LesKaribous/Karibous-2026-PAMI/README.md

# Project-Template
Template de projet avec documentation
