LesKaribous/Karibous-2026-PAMI/MCAD/squirrel-design/path270-5-2-4-5.png

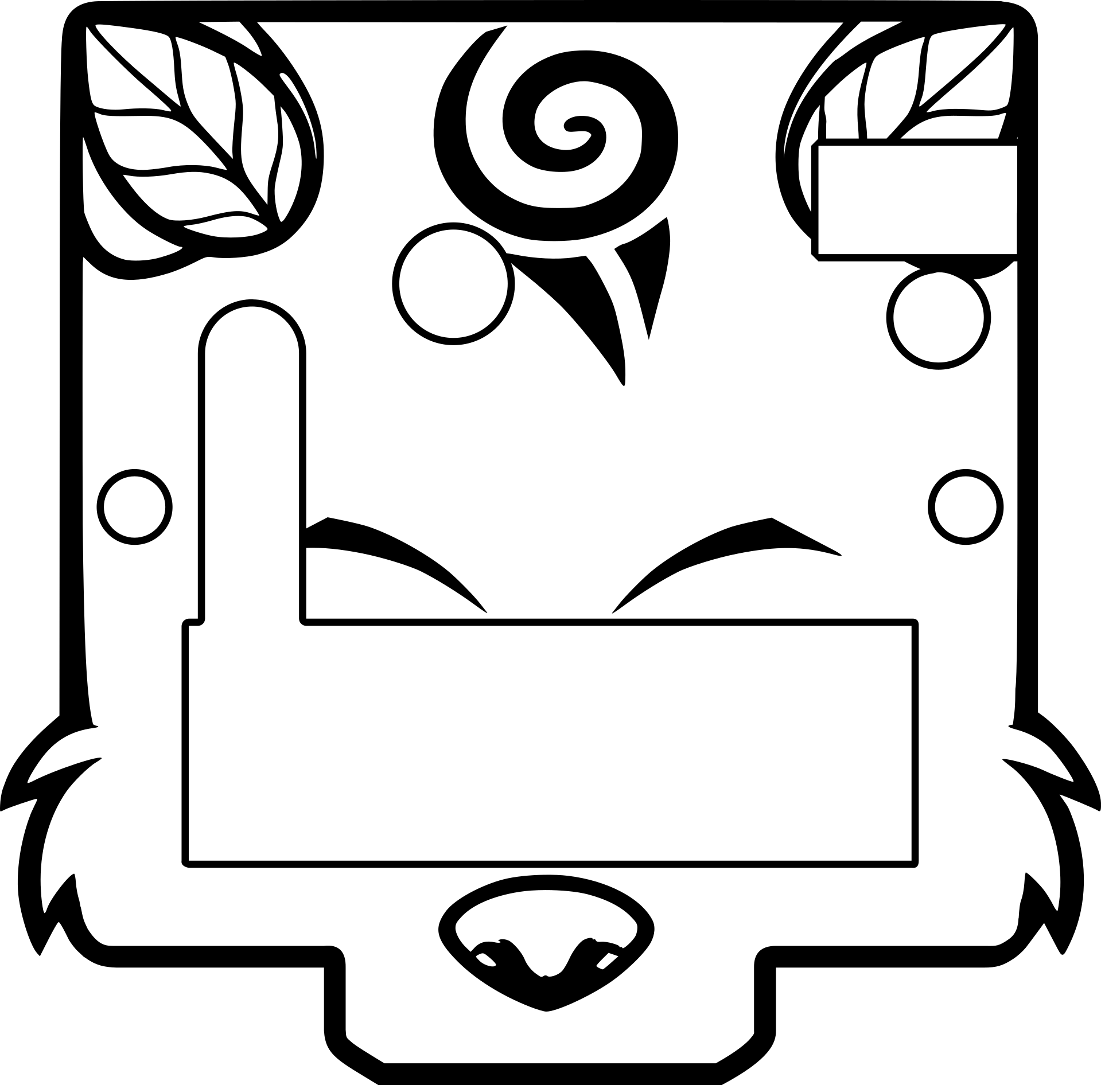
MCAD/squirrel-design/path270-5-2-4-5.png
