LesKaribous/Karibous-2026-PAMI/MCAD/squirrel-design/queueBabyPami.png

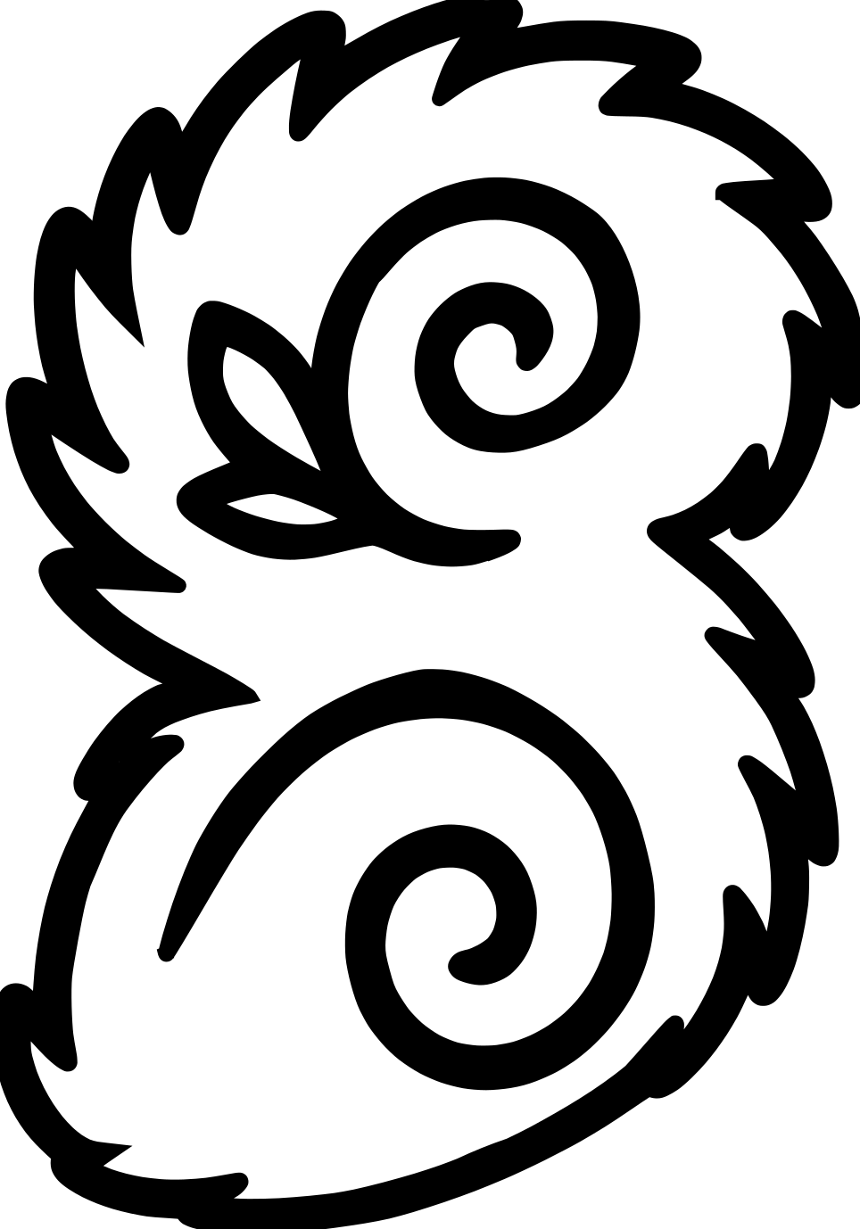
MCAD/squirrel-design/queueBabyPami.png
