LesKaribous/Karibous-2026-PAMI/MCAD/squirrel-design/top.png

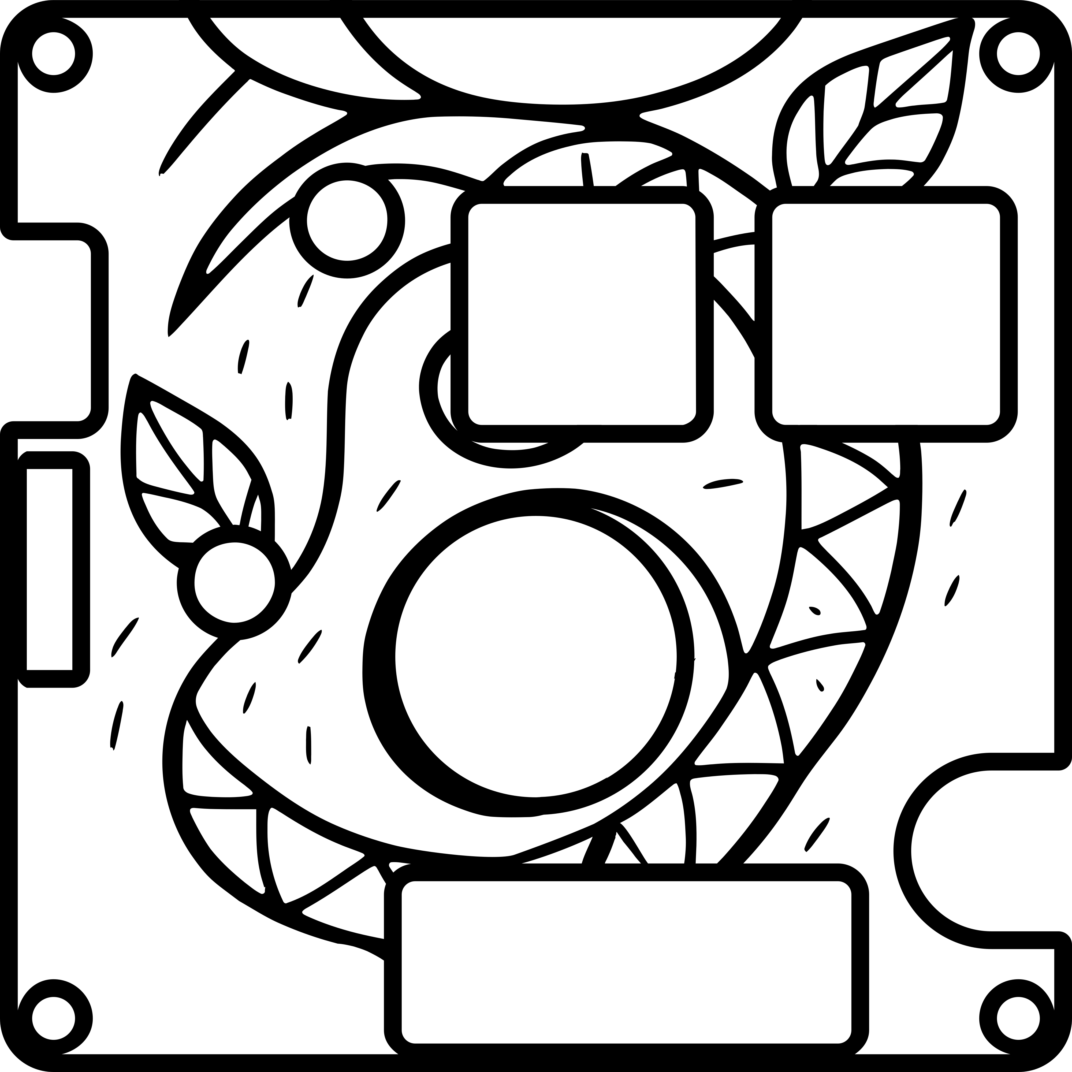
MCAD/squirrel-design/top.png
