LesKaribous/Karibous-2026-PAMI/MCAD/3d-print/Main-body.3mf

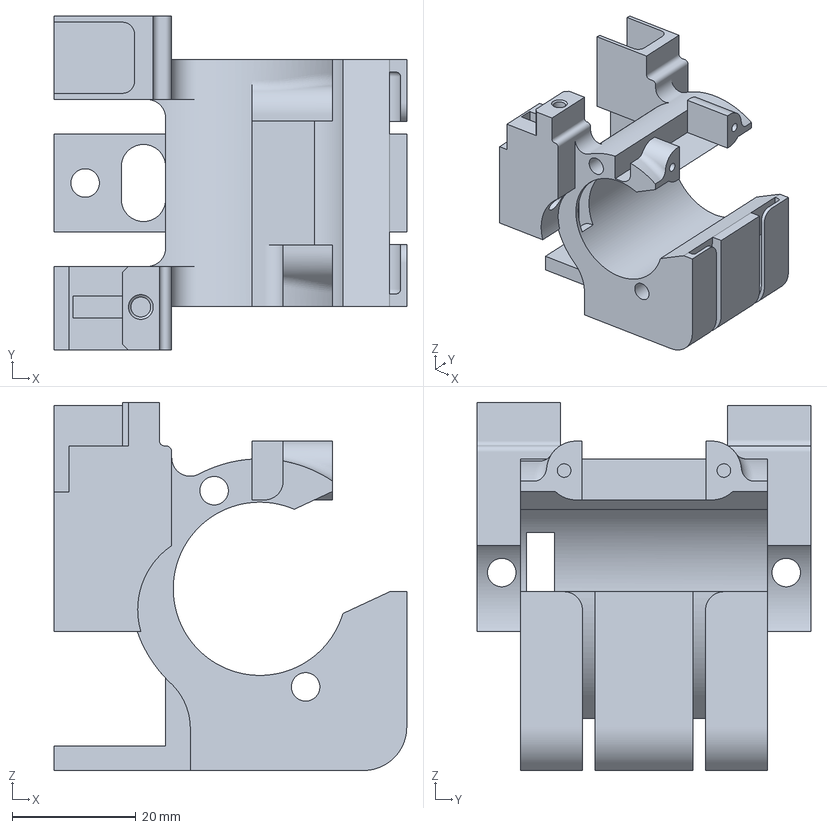
[picture p4: CAD file, 2026-01-24]
MCAD/3d-print/Main-body.3mf
57.0 x 54.0 x 59.5 mm
