LesKaribous/Karibous-2026-PAMI/ECAD/MicroPAMI-2026/MicroPAMI-2026.step

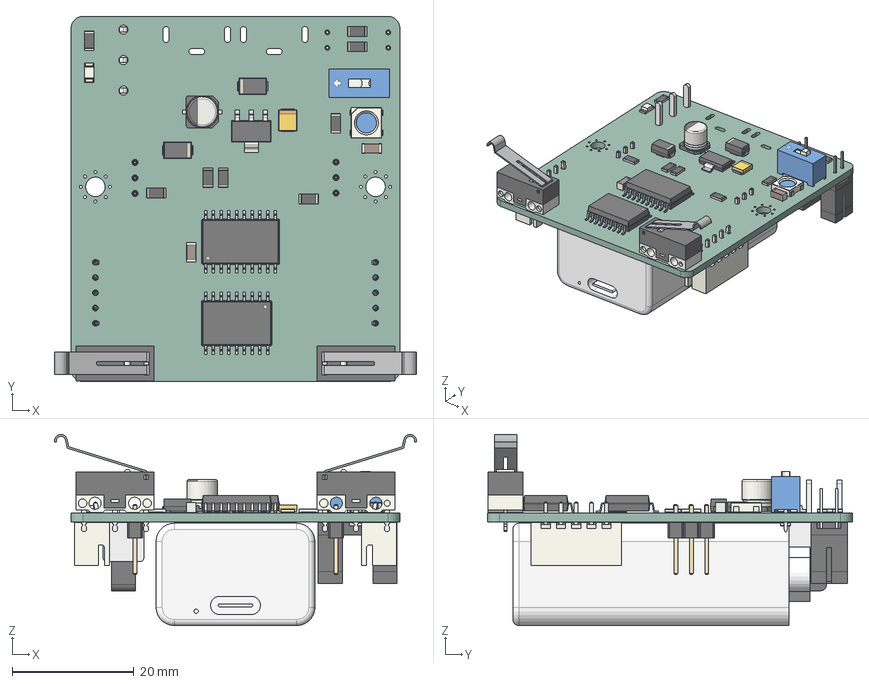
[picture p5: CAD file, 2025-12-31]
ECAD/MicroPAMI-2026/MicroPAMI-2026.step
59.4 x 60.0 x 31.4 mm
R_1206_3216Metric x 9
D_SMA x 2
SOIC-18W_7.5x11.6mm_P1.27mm
LED_1206_3216Metric
SW_DIP_SPSTx01_Slide_9.78x4.72mm_W7.62mm_P2.54mm
C_1206_3216Metric x 2
Bottom001 x 2
Top001 x 2
Plunger001 x 2
Lever_16U001 x 2
Pin_NO005 x 2
Pin_C005 x 2
Pin_NC005 x 2
CP_Elec_5x5.4
SOT-223
LED_WS2812B_PLCC4_5.0x5.0mm_P3.2mm
CP_EIA-3528-12_Kemet-T
SOIC-20W_7.5x12.8mm_P1.27mm
PinHeader_1x03_P2.54mm_Vertical x 2
Everlight_ITR9608-F
Pin
Lever
JST_XH_B5B-XH-A_1x05_P2.50mm_Vertical x 2
9V Battery
MicroPAMI-2026_PCB
