LesKaribous/Karibous-2026-PAMI/MCAD/3d-print/Tirette.3mf

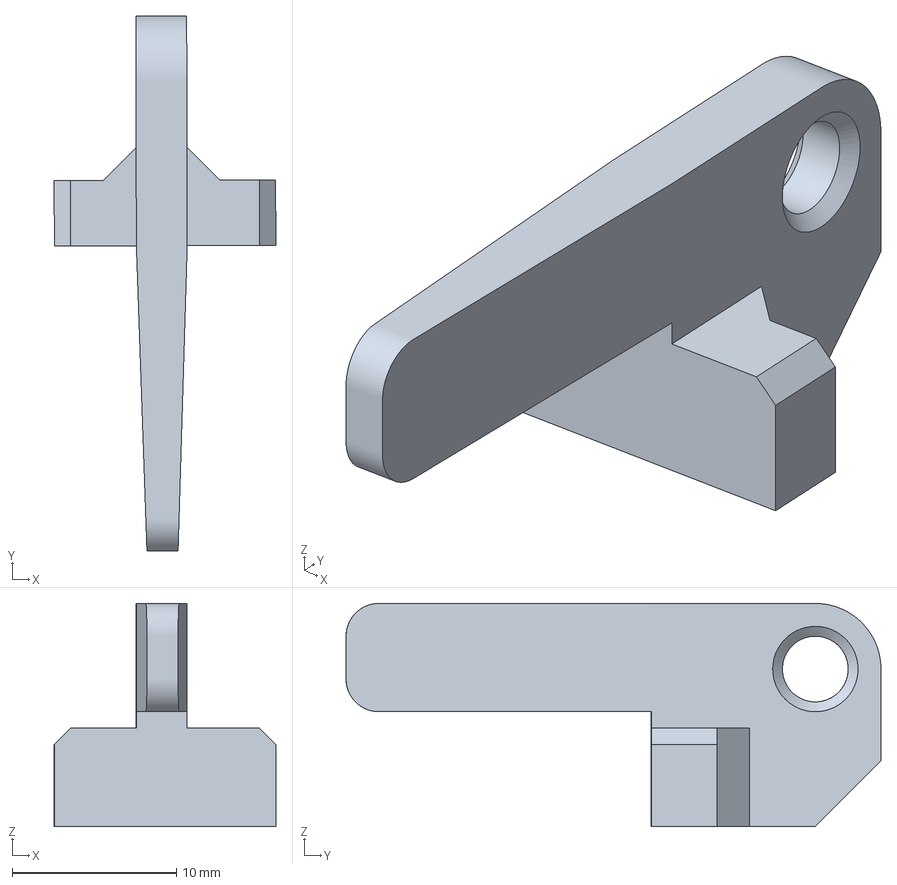
[picture p6: CAD file, 2026-01-25]
MCAD/3d-print/Tirette.3mf
13.5 x 32.6 x 13.6 mm
