LesKaribous/Karibous-2026-PAMI/MCAD/gridfinityBox.FCStd

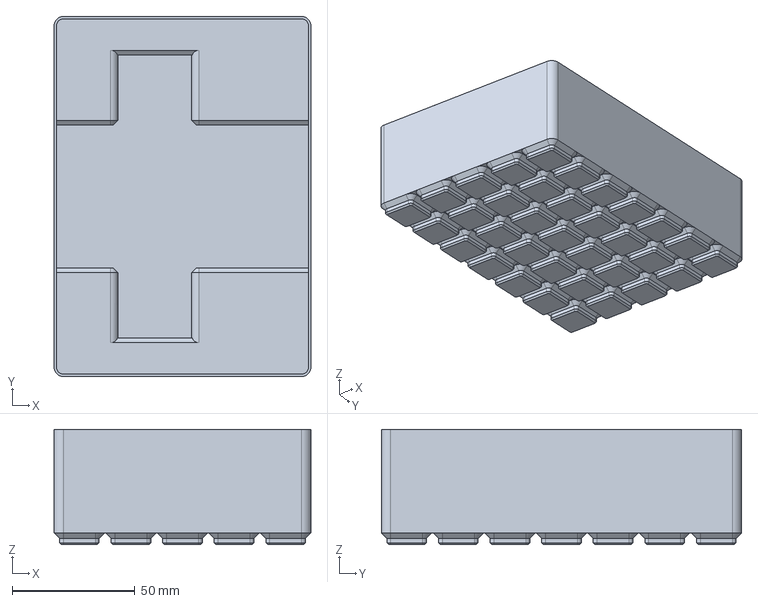
[picture p7: CAD file, 2026-04-16]
MCAD/gridfinityBox.FCStd
104.5 x 146.5 x 47.0 mm
