LesKaribous/Karibous-2026-PAMI/MCAD/squirrel-design/MicroPami_FrontPanel.3mf

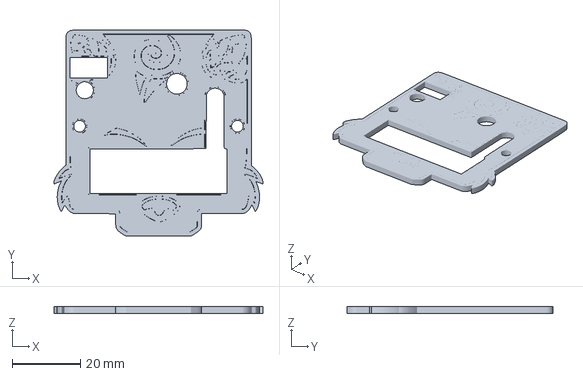
[picture p8: CAD file, 2026-01-25]
MCAD/squirrel-design/MicroPami_FrontPanel.3mf
61.2 x 60.4 x 2.00 mm
