LesKaribous/Karibous-2026-PAMI/MCAD/CalePami.FCStd

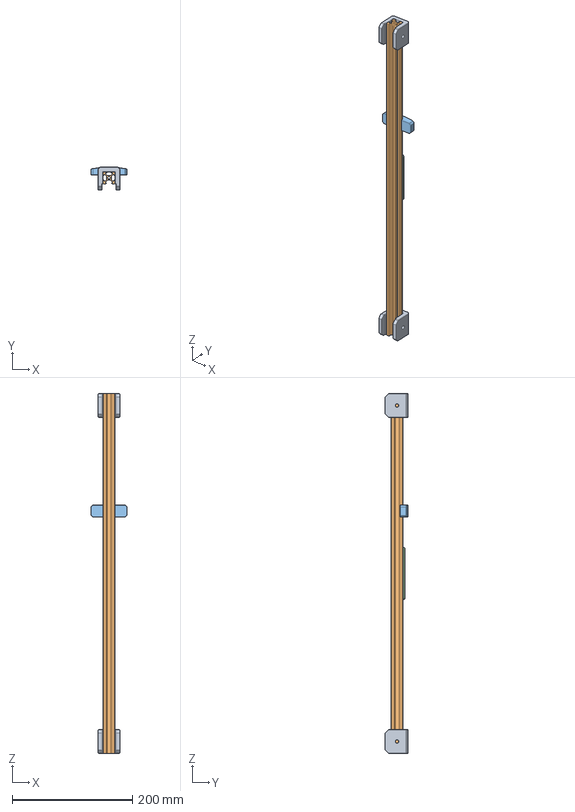
[picture p9: CAD file, 2026-03-24]
MCAD/CalePami.FCStd
60.0 x 38.0 x 600.0 mm
Clip-Lateral x 2
2020-600mm
Clip-Spacer
Etiquette
