LesKaribous/Karibous-2026-PAMI/MCAD/squirrel-design/MicroPami-MicroPami-2026Wheel.3mf

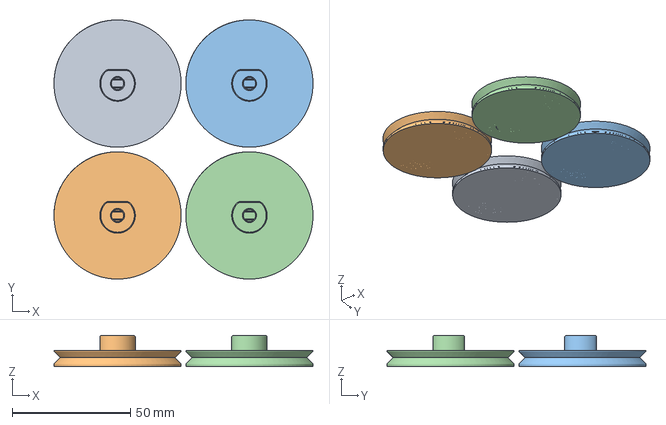
[picture p10: CAD file, 2026-01-24]
MCAD/squirrel-design/MicroPami-MicroPami-2026Wheel.3mf
109.4 x 109.5 x 13.2 mm
Wheel x 4
