LesKaribous/Karibous-2026-PAMI/MCAD/CalePami-Clip-Lateral.3mf

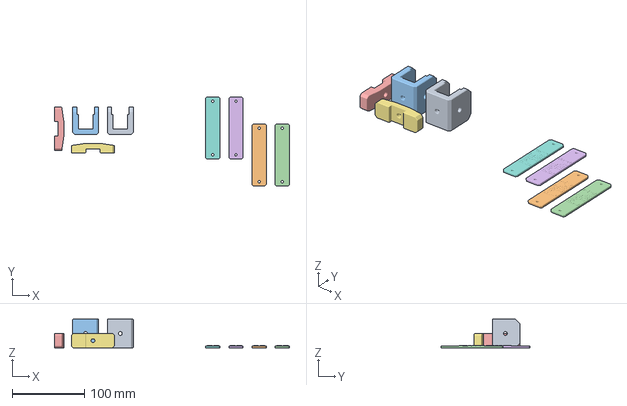
[picture p11: CAD file, 2026-03-06]
MCAD/CalePami-Clip-Lateral.3mf
325.0 x 123.3 x 40.0 mm
