LesKaribous/Karibous-2026-PAMI/MCAD/squirrel-design/Ear-2026.FCStd

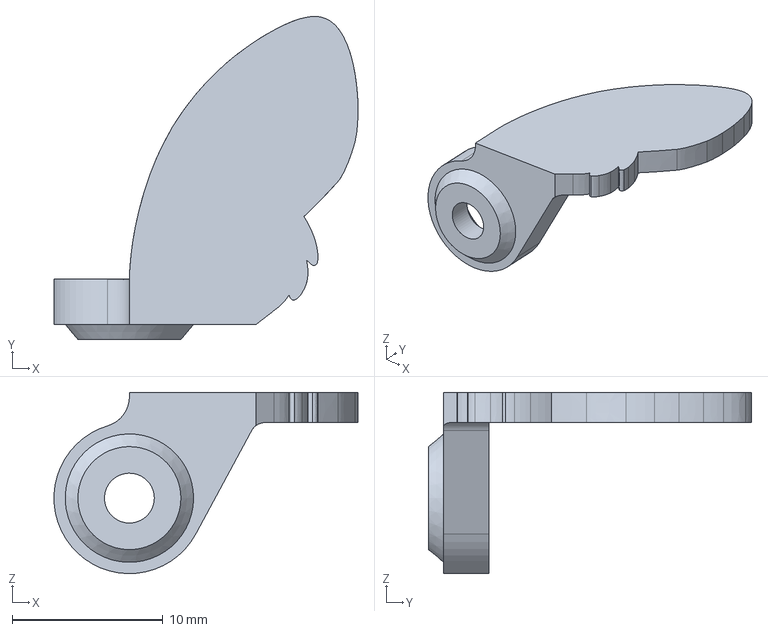
[picture p12: CAD file, 2025-12-07]
MCAD/squirrel-design/Ear-2026.FCStd
20.1 x 21.4 x 12.0 mm
