LesKaribous/Karibous-2026-PAMI/MCAD/MicroPami.FCStd

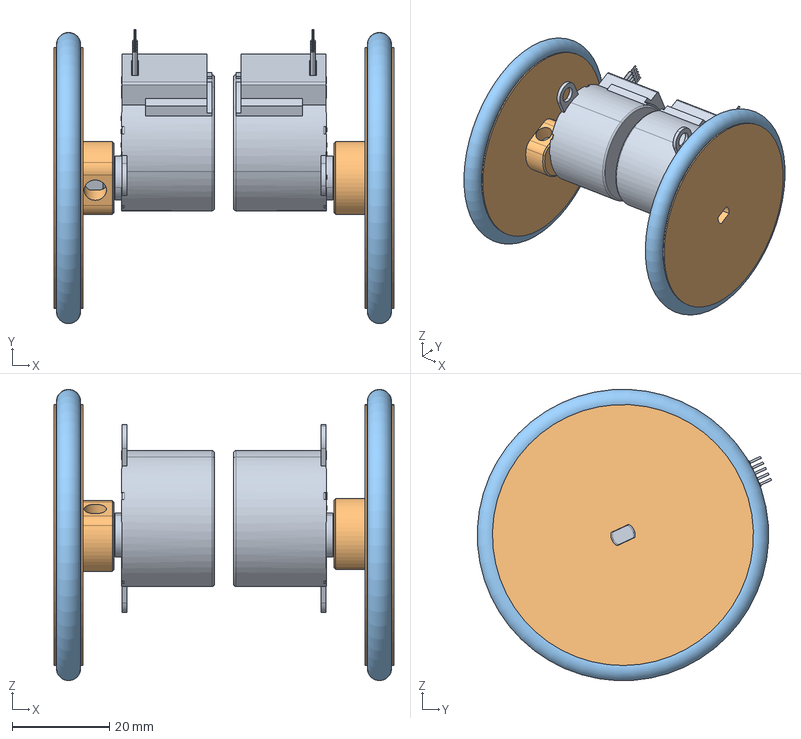
[picture p13: CAD file, 2025-12-30]
MCAD/MicroPami.FCStd
70.0 x 60.6 x 59.9 mm
28BYJ-48_Stepper x 2
Wheel x 2
Torique60mm x 2
