LesKaribous/Karibous-2026-PAMI/MCAD/squirrel-design/squirrel-design.3mf

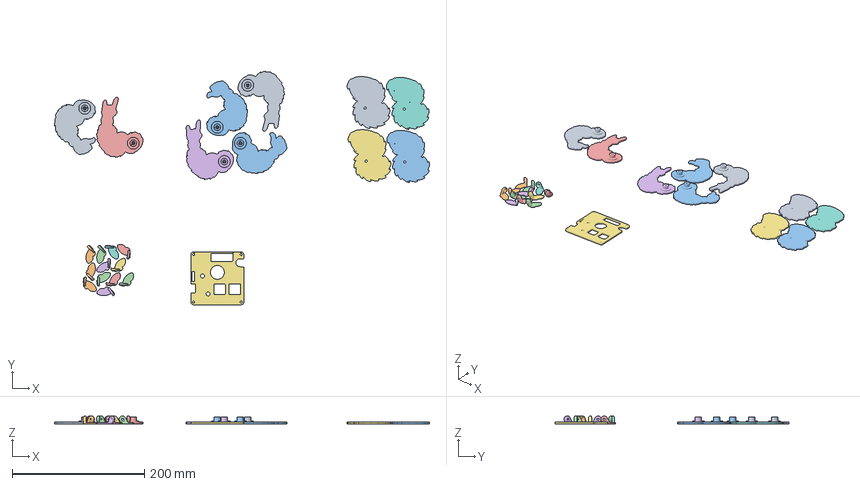
[picture p14: CAD file, 2025-12-07]
MCAD/squirrel-design/squirrel-design.3mf
566.6 x 353.0 x 12.0 mm
Assembly x 6
EAR-Left x 6
queue.svg x 4
EAR-Right x 6
top.svg
