LesKaribous/Karibous-2026-PAMI/MCAD/squirrel-design/PAMI-2026ServoArm.3mf

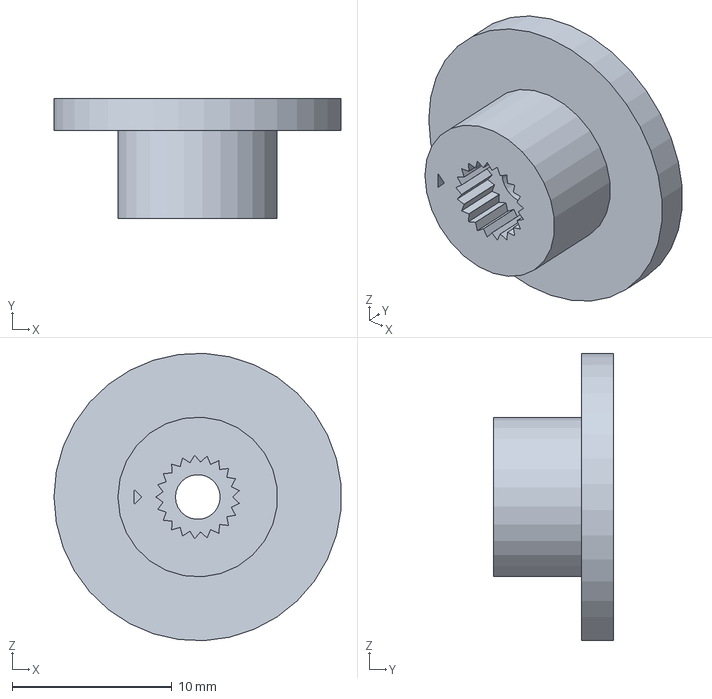
[picture p15: CAD file, 2025-12-07]
MCAD/squirrel-design/PAMI-2026ServoArm.3mf
18.0 x 7.50 x 18.0 mm
