LesKaribous/Karibous-2026-PAMI/MCAD/squirrel-design/TopTransparentElecCover.3mf

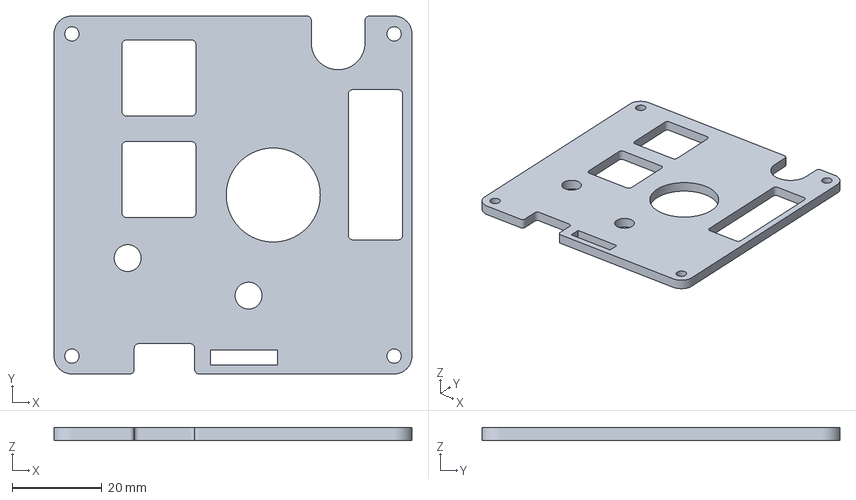
[picture p16: CAD file, 2025-12-07]
MCAD/squirrel-design/TopTransparentElecCover.3mf
80.0 x 80.0 x 3.00 mm
