LesKaribous/Karibous-2026-PAMI/(list of files, cad)

Other CAD files:
MCAD/squirrel-design/Ear-2026-Body.3mf
