LesKaribous/Karibous-2026-PAMI/ECAD/MicroPAMI-2026/MicroPAMI-2026.kicad_pcb

## KiCad design ECAD/MicroPAMI-2026/MicroPAMI-2026.kicad_pcb (2026-01-13)

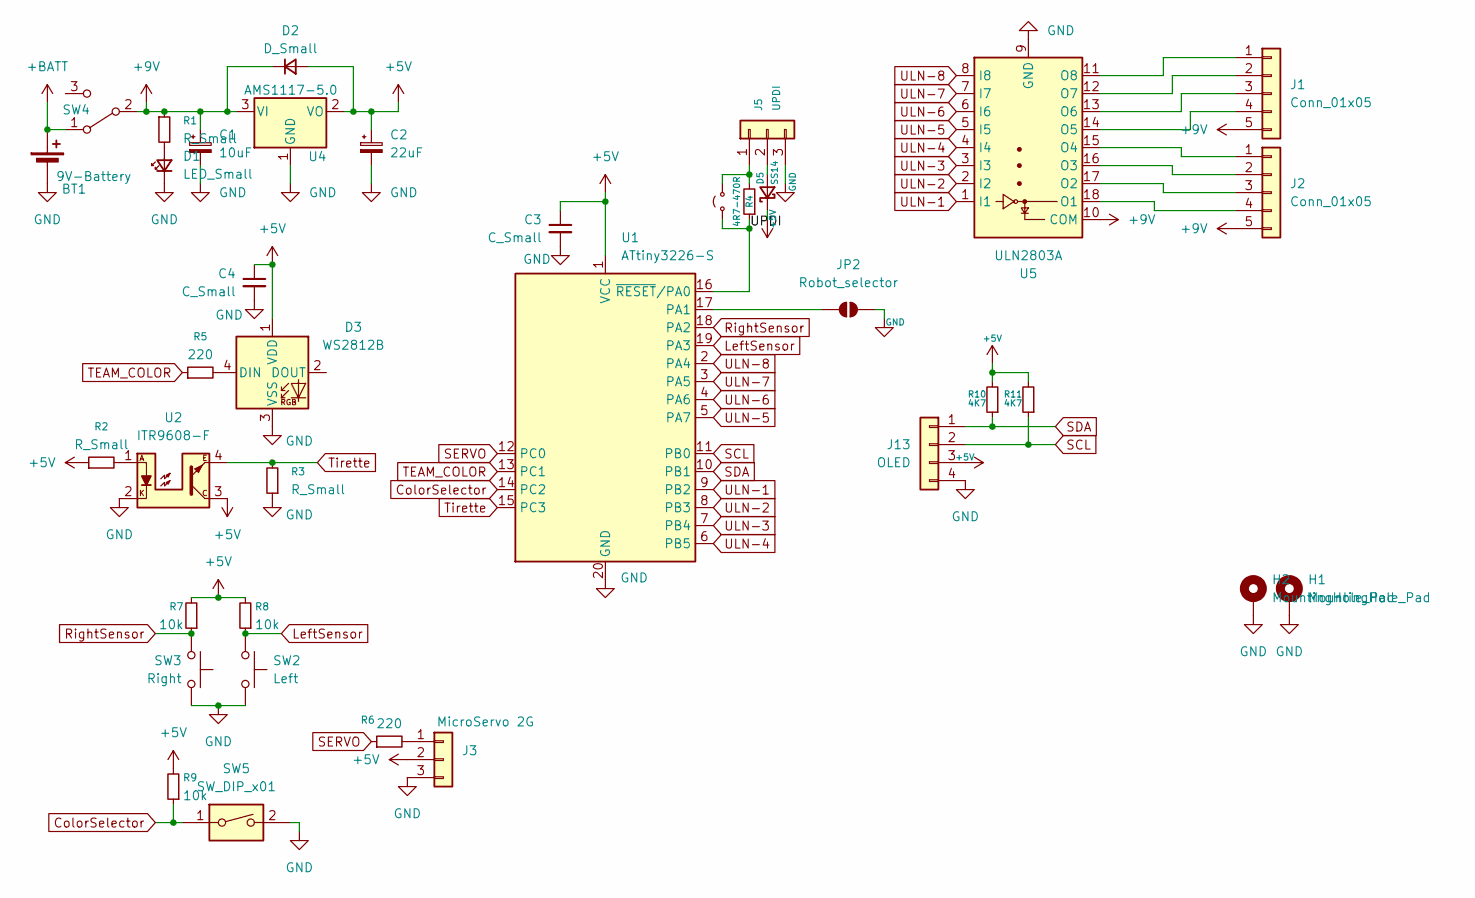
[picture p17: schematic MicroPAMI-2026.kicad_sch]

Parts:
BT1: 9V-Battery; 9V-PP3
C1: 10uF; CP_Elec_5x5.4
C2: 22uF; CP_EIA-3528-12_Kemet-T_Pad1.50x2.35mm_HandSolder
C3, C4: C_Small; C_1206_3216Metric_Pad1.33x1.80mm_HandSolder
D1: LED_Small; LED_1206_3216Metric_Pad1.42x1.75mm_HandSolder
D2: D_Small; D_SMA_Handsoldering
D3: WS2812B; LED_WS2812B_PLCC4_5.0x5.0mm_P3.2mm
D5: SS14; D_SMA_Handsoldering
H1, H2: MountingHole_Pad; MountingHole_3.2mm_M3_Pad_Via
J1, J2: Conn_01x05; JST_XH_B5B-XH-A_1x05_P2.50mm_Vertical
J3: MicroServo 2G; PinHeader_1x03_P2.54mm_Vertical
J5: UPDI; PinHeader_1x03_P2.54mm_Vertical
J13: OLED; PinSocket_1x04_P2.54mm_Vertical
JP1: Jumper_2_Small_Open; SolderJumper-2_P1.3mm_Open_RoundedPad1.0x1.5mm
JP2: Robot_selector; SolderJumper-2_P1.3mm_Open_RoundedPad1.0x1.5mm
R1, R2, R3: R_Small; R_1206_3216Metric_Pad1.30x1.75mm_HandSolder
R4: 4R7-470R; R_1206_3216Metric_Pad1.30x1.75mm_HandSolder
R5, R6: 220; R_1206_3216Metric_Pad1.30x1.75mm_HandSolder
R7, R8, R9: 10k; R_1206_3216Metric_Pad1.30x1.75mm_HandSolder
R10, R11: 4K7; R_1206_3216Metric_Pad1.30x1.75mm_HandSolder
SW2: Left; SW_XKB_DM1-16UP-1
SW3: Right; SW_XKB_DM1-16UP-1
SW4: SW_SPDT; SK-12D10 1P2T
SW5: SW_DIP_x01; SW_DIP_SPSTx01_Slide_9.78x4.72mm_W7.62mm_P2.54mm
U1: ATtiny3226-S; SOIC-20W_7.5x12.8mm_P1.27mm
U2: ITR9608-F; Everlight_ITR9608-F
U4: AMS1117-5.0; SOT-223-3_TabPin2
U5: ULN2803A; SOIC-18W_7.5x11.6mm_P1.27mm

Connections:
+5V: C2.1, C3.1, C4.1, D2.2 (A), D3.1 (VDD), D5.1 (K), J3.2, J13.3, R2.1, R7.2, R8.2, R9.2, R10.2, R11.2, U1.1 (VCC), U2.3, U4.2 (VO)
+9V: C1.1, D2.1 (K), J1.5, J2.5, R1.1, SW4.2 (B), U4.3 (VI), U5.10 (COM)
+BATT: BT1.1 (+), SW4.1 (A)
/UPDI: JP1.1 (A), R4.1, U1.16 (~RESET/PA0)
ColorSelector: R9.1, SW5.1, U1.14 (PC2)
GND: BT1.2 (-), C1.2, C2.2, C3.2, C4.2, D1.1 (K), D3.3 (VSS), H1.1, H2.1, J3.3, J5.3, J13.4, JP2.2 (B), R3.1, SW2.2, SW3.2, SW5.2, U1.20 (GND), U2.2, U4.1 (GND), U5.9 (GND)
LeftSensor: R8.1, SW2.1, U1.19 (PA3)
unnamed: D1.2 (A), R1.2
unnamed: D3.4 (DIN), R5.2
unnamed: D5.2 (A), J5.2
unnamed: J1.1, U5.11 (O8)
unnamed: J1.2, U5.12 (O7)
unnamed: J1.3, U5.13 (O6)
unnamed: J1.4, U5.14 (O5)
unnamed: J2.1, U5.15 (O4)
unnamed: J2.2, U5.16 (O3)
unnamed: J2.3, U5.17 (O2)
unnamed: J2.4, U5.18 (O1)
unnamed: J3.1, R6.2
unnamed: J5.1, JP1.2 (B), R4.2
unnamed: JP2.1 (A), U1.17 (PA1)
unnamed: R2.2, U2.1
RightSensor: R7.1, SW3.1, U1.18 (PA2)
SCL: J13.2, R11.1, U1.11 (PB0)
SDA: J13.1, R10.1, U1.10 (PB1)
SERVO: R6.1, U1.12 (PC0)
TEAM_COLOR: R5.1, U1.13 (PC1)
Tirette: R3.2, U1.15 (PC3), U2.4
ULN-1: U1.9 (PB2), U5.1 (I1)
ULN-2: U1.8 (PB3), U5.2 (I2)
ULN-3: U1.7 (PB4), U5.3 (I3)
ULN-4: U1.6 (PB5), U5.4 (I4)
ULN-5: U1.5 (PA7), U5.5 (I5)
ULN-6: U1.4 (PA6), U5.6 (I6)
ULN-7: U1.3 (PA5), U5.7 (I7)
ULN-8: U1.2 (PA4), U5.8 (I8)

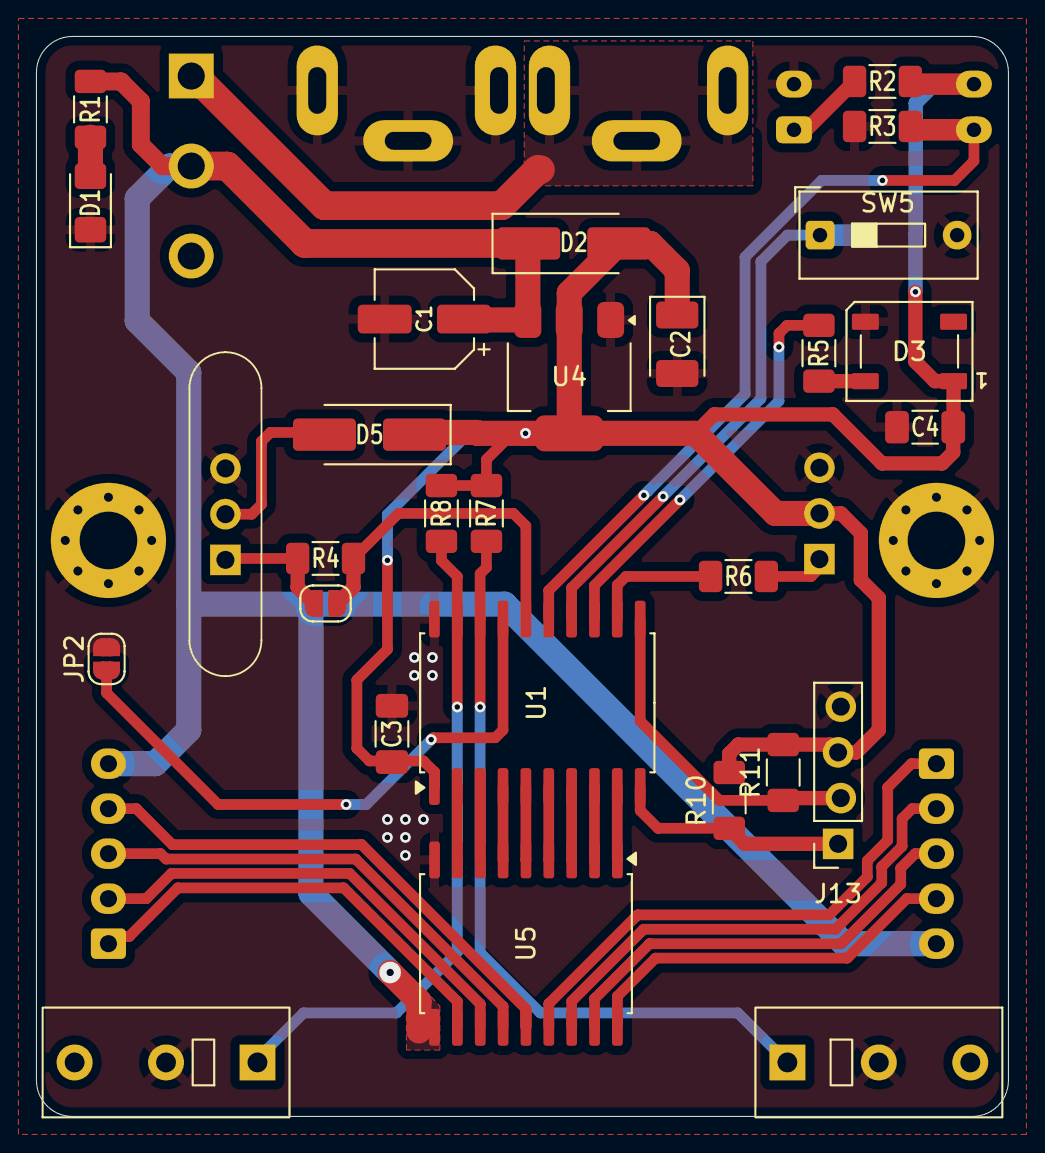
[picture p18: board MicroPAMI-2026.kicad_pcb from above]

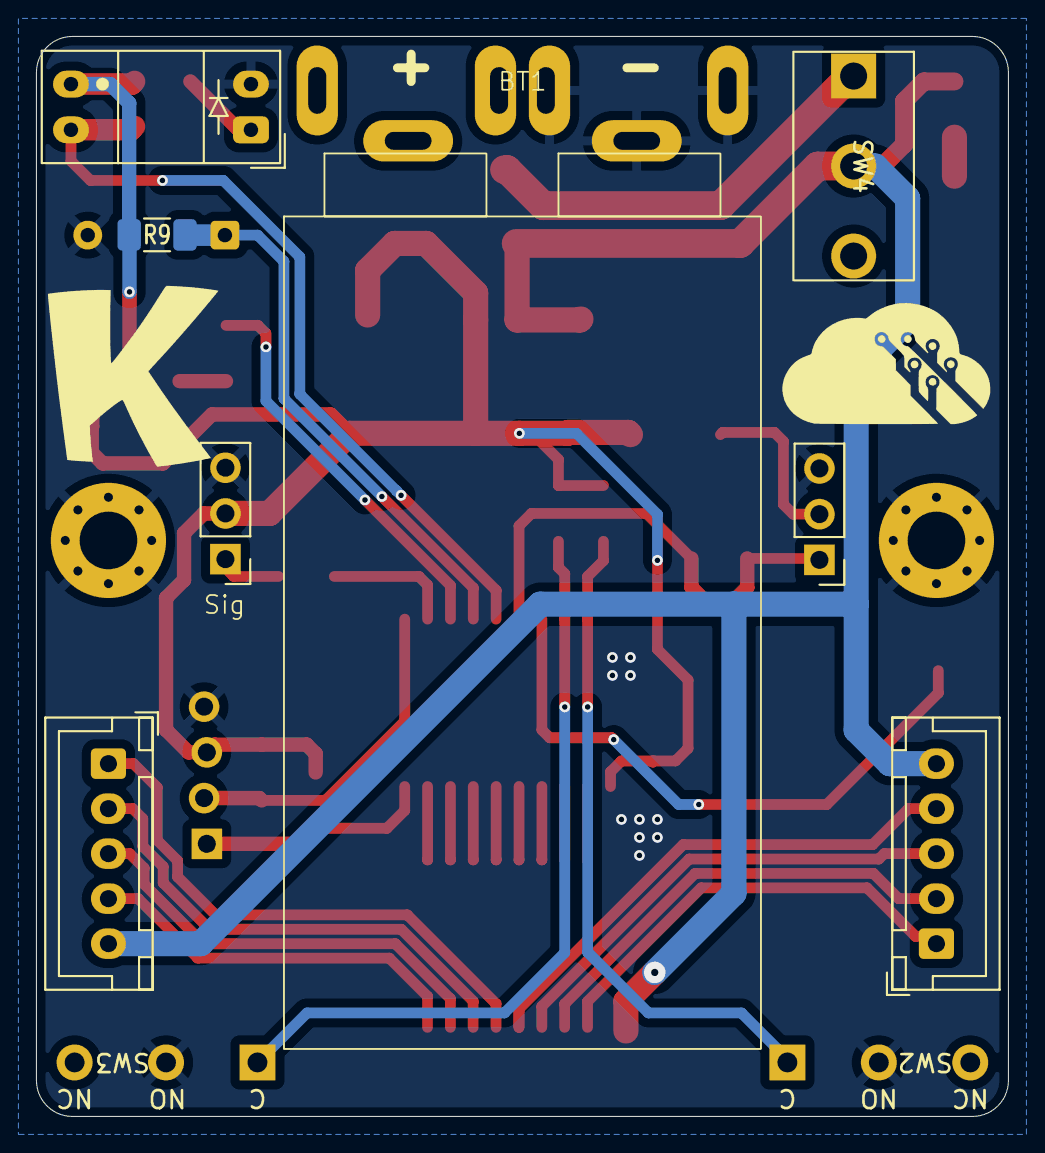
[picture p19: board MicroPAMI-2026.kicad_pcb from below]

Board: 2 copper layers, 54.0 x 60.0 mm, 37 parts (8 on the bottom side), 36 nets.
