LesKaribous/Karibous-2026-PAMI/FIRMWARE/Firmware-PAMI-2026/src/pins.h

// pins.h
#ifndef PINS_H
#define PINS_H

// Pins Robot Number
const int BotNumb01 = 2;
const int BotNumb02 = 1;

// Pins Motors - Drivers
const int EN      = 12;
const int STEP_G  = 21;
const int DIR_G   = 47;
const int STEP_D  = 10;
const int DIR_D   = 11;
const int MS1 = 13;
const int MS2 = 14;

// Pins IHM
const int ColorTeam = 6;
const int Tirette   = 5;
const int ledStatus = 4;
const int Buzzer = 18;

// Pins servo
const int pinServo01  = 7;
const int pinServo02  = 3;

// Pins Sensors
const int xshutPins[3] = { 38,17,48 };

#endif // PINS_H
