LesKaribous/Karibous-2026-PAMI/(commit log)

2025-11-29 Add squirrel design
    [Ear-2026-Body.3mf, Ear-2026.FCStd, PAMI-2026ServoArm.3mf, squirrel-design.3mf]
2025-11-30 update designs
    [TopTransparentElecCover.3mf, squirrel-design.3mf]
2025-12-07 proto ninja
    [17HE15-1504S.STEP, ProtoNINJA.FCStd]
2025-12-07 live 246
    [17HE12-1204S.STEP, BAU.step, CanonLPE6-Canon.step, GENERIC-370_vaccum-pump-12V-4Lmin.STEP, ProtoNINJA.FCStd, pump-assembled.FCStd]
2025-12-10 new attiny mini version
    [MicroPAMI-2026.kicad_pcb, MicroPAMI-2026.kicad_sch]
2025-12-10 new mini pump pcb
    [PumpBoard-2026-B_Cu.gbr, PumpBoard-2026-B_Mask.gbr, PumpBoard-2026-B_Paste.gbr, PumpBoard-2026-B_Silkscreen.gbr, PumpBoard-2026-Edge_Cuts.gbr, PumpBoard-2026-F_Cu.gbr, PumpBoard-2026-F_Mask.gbr, PumpBoard-2026-F_Paste.gbr]
2025-12-10 change capacitor size
    [PumpBoard-2026.kicad_pcb, PumpBoard-2026.kicad_sch]
2025-12-10 Update PCB: add resistors, change net assignments
    Added R3 and R8 SMD resistors to the PCB layout and updated net assignments for several signals, including connections for Tirette, LeftSensor, and others. Replaced unconnected net labels with specific net names for improved clarity. Updated backup files and made minor changes to project and cache files.
    [MicroPAMI-2026.kicad_pcb, MicroPAMI-2026.kicad_sch]
2025-12-30 Update battery position and change component orientation
    [MicroPAMI-2026.kicad_pcb, PAMI-Ninja-2026.kicad_pcb, PAMI-Ninja-2026.kicad_sch]
2025-12-30 Board routing
    [MicroPAMI-2026.kicad_pcb, MicroPAMI-2026.kicad_sch, MicroPAMI-2026.step]
2025-12-30 Create PCB part and wheels
    [28BYJ-48_Stepper.STEP, MicroPami.FCStd]
2025-12-31 update BAU - add oled
    [MicroPAMI-2026.kicad_pcb, MicroPAMI-2026.kicad_sch, MicroPAMI-2026.step]
2025-12-31 Add Gh-S37D Servo STEP file and update MicroPami.FCStd
    [Gh-S37D Servo.STEP]
2025-12-31 add a robot selector jumper
    [MicroPAMI-2026.kicad_pcb, MicroPAMI-2026.kicad_sch]
2026-01-01 add I2C resistor
    [MicroPAMI-2026.kicad_pcb, MicroPAMI-2026.kicad_sch]
2026-01-07 add pogo for programming
    [MicroPAMI-2026.kicad_pcb]
2026-01-13 update to production POC
    [MicroPAMI-2026.kicad_pcb]
2026-01-13 New ninja pami 2026
    [NinjaPAMI-2026.kicad_pcb, NinjaPAMI-2026.kicad_sch]
2026-01-15 change dimensions
    [NinjaPAMI-2026.kicad_pcb]
2026-01-19 change uC value
    [MicroPAMI-2026.kicad_sch]
2026-01-19 solve real pcb integration
2026-01-24 new pcb export
2026-01-24 new wheel design
    [MicroPami-MicroPami-2026Wheel.3mf]
2026-01-24 modify body for pull start
    [Main-body.3mf]
2026-01-24 Update Main-body.3mf 3D model file
    [Main-body.3mf]
2026-01-24 PAMI ninja PCB update
    [NinjaPAMI-2026.kicad_pcb, NinjaPAMI-2026.kicad_sch, PAMI-Ninja-2026.kicad_pcb, PAMI-Ninja-2026.kicad_sch]
2026-01-25 new front panel for micro PAMI
    [MicroPami_FrontPanel.3mf]
2026-01-25 transfer "PAMI Ninja" to dedicated repo
    [17HE12-1204S.STEP, 17HE15-1504S.STEP, 28BYJ-48_Stepper.STEP, BAU.step, CanonLPE6-Canon.step, GENERIC-370_vaccum-pump-12V-4Lmin.STEP, Gh-S37D Servo.STEP, NinjaPAMI-2026.kicad_pcb]
2026-01-25 add "tirette"
    [Tirette.3mf]
2026-03-24 strategy 2026
    [CalePami.FCStd]
2026-04-10 new tirette
